AAlsaati/SmartWatch/Hardware/Basic/Bottom/SmartWatch-BASIC-Bottom-BOM.xlsx

Design Name -- Revision Code / Designer or Organization Name |  |  |  |  |  |  |  |  |  |  | Total | $21.12 | Total (in Bulk) | $0.00
BOM # | Comment | Designator | Description | Mounting Type | Package | Manufacturer | Manufacturer Part Number | Supplier | Supplier Part Number | Price per unit | Quantity | Total | Per 100 | Total
Filters
 | Op Amp - MCP6004 | OP3 | General Purpose Amplifier 4 Circuit Rail-to-Rail 14-SOIC | SMD | 14-SOIC | Microchip Technology | MCP6004T-I/SL | Digi-Key | MCP6004T-I/SLCT-ND | $0.44 | 6 | $2.64
 | 100 nF Capacitor | C10 | 0.1µF ±5% 16V Ceramic Capacitor X7R 0603 (1608 Metric) | SMD | 0603 | Yageo | CC0603JRX7R7BB104 | Digi-Key | 311-1776-1-ND | $0.03 | 1 | $0.03
 | 2.2u capacitor | C15, C16 | 2.2µF ±10% 16V Ceramic Capacitor X5R 0603 (1608 Metric) | SMD | 0603 | Samsung Electro-Mechanics | CL10A225KO8NNNC | Digi-Key | 1276-1040-1-ND | $0.03 | 2 | $0.06
 | 2.2n Capacitor | C14, C19 | 2200pF ±10% 50V Ceramic Capacitor X7R 0603 (1608 Metric) | SMD | 0603 | Walsin Technology Corporation | 0603B222K500CT | Digi-Key | 1292-1412-1-ND | $0.01 | 2 | $0.02
 | 22u capacitor | C20 | 22µF ±20% 10V Ceramic Capacitor X5R 0603 (1608 Metric) | SMD | 0603 | Samsung Electro-Mechanics | CL10A226MP8NUNE | Digi-Key | 1276-1274-1-ND | $0.07 | 1 | $0.07
 | 22n capacitor | C21 | 0.022µF ±10% 50V Ceramic Capacitor X7R 0603 (1608 Metric) | SMD | 0603 | Samsung Electro-Mechanics | CL10B223KB8NNNC | Digi-Key | 1276-1104-1-ND | $0.02 | 1 | $0.02
 | 220k resistor | R13, R19, R21, R15 | 220 kOhms ±1% 0.1W, 1/10W Chip Resistor 0603 (1608 Metric) Automotive AEC-Q200 Thick Film | SMD | 0603 | Stackpole Electronics Inc | RMCF0603FT220K | Digi-Key | RMCF0603FT220KCT-ND | $0.01 | 4 | $0.02
 | 10M Resistor | R14,R22 | 10 MOhms ±1% 0.1W, 1/10W Chip Resistor 0603 (1608 Metric) Automotive AEC-Q200 Thick Film | SMD | 0603 | Stackpole Electronics Inc | RMCF0603FT10M0 | Digi-Key | RMCF0603FT10M0CT-ND | $0.01 | 2 | $0.02
 | 1M Resistor | R20, R23 | 1 MOhms ±1% 0.1W, 1/10W Chip Resistor 0603 (1608 Metric) Automotive AEC-Q200 Thick Film | SMD | 0603 | Stackpole Electronics Inc | RMCF0603FT1M00 | Digi-Key | RMCF0603FT1M00CT-ND | $0.01 | 2 | $0.01
 | 10k Resistor | R24 | 10 kOhms ±1% 0.1W, 1/10W Chip Resistor 0603 (1608 Metric) Automotive AEC-Q200 Thick Film | SMD | 0603 | Stackpole Electronics Inc | RMCF0603FT10K0 | Digi-Key | RMCF0603FT10K0CT-ND | $0.01 | 1 | $0.01
 | 100 nF Capacitor | C22,C11,C1 | 0.1µF ±5% 16V Ceramic Capacitor X7R 0603 (1608 Metric) | SMD | 0603 | Yageo | CC0603JRX7R7BB104 | Digi-Key | 311-1776-1-ND | $0.03 | 100 | $3.31
 | 10k Resistor | R17, R18 | 10 kOhms ±1% 0.1W, 1/10W Chip Resistor 0603 (1608 Metric) Automotive AEC-Q200 Thick Film | SMD | 0603 | Stackpole Electronics Inc | RMCF0603FT10K0 | Digi-Key | RMCF0603FT10K0CT-ND | $0.01 | 100 | $0.59
Pontentiometer
 | AD5242 | AD5242 | Digital Potentiometer 1M Ohm 2 Circuit 256 Taps I²C Interface 16-SOIC | SMD | 16-SOIC | Analog Devices Inc. | AD5242BRZ1M | Digi-Key | AD5242BRZ1M-ND | $3.47 | 1 | $3.47
 | AD5171 | AD5171 | Digital Potentiometer ICs IC 6-Bit OTP I2C | SMD | SOT-23-8 | Analog Devices | AD5171BRJZ100-R7 | Mouser | 584-AD5171BRJZ100-R7 | $2.68 | 1 | $2.68
 | 100 nF Capacitor | C17, C18 | 0.1µF ±5% 16V Ceramic Capacitor X7R 0603 (1608 Metric) | SMD | 0603 | Yageo | CC0603JRX7R7BB104 | Digi-Key | 311-1776-1-ND | $0.03 | 2 | $0.07
 |  | R16
 | NPN-Generic | Q1 | Bipolar (BJT) Transistor NPN 40V 600mA 300MHz 250mW Surface Mount TO-236AB | SMD | TO-236AB | Nexperia USA Inc. | PMBT2222A,215 | Digi-Key | 1727-2956-1-ND | $1.05 | 1 | $1.05
IMU
 | LSM6DS3 castellated breakout
 | 100 nF Capacitor | C25 | 0.1µF ±5% 16V Ceramic Capacitor X7R 0603 (1608 Metric) | SMD | 0603 | Yageo | CC0603JRX7R7BB104 | Digi-Key | 311-1776-1-ND | $0.03 | 1 | $0.03
 | CONN_07-1.27MM (CONN_07) |  | 50 Position Header Connector 0.050" (1.27mm) Through Hole Gold | THT |  | Sullins Connector Solutions | LPPB501NFFN-RC | Digi-Key | S9008E-50-ND | $5.06 | 1 | $5.06
RTC
 | PCF8523 | U3 | Real Time Clock (RTC) IC Clock/Calendar I²C, 2-Wire Serial 8-SOIC (0.154", 3.90mm Width) | SMD | 8-SO | NXP USA Inc. | PCF8523T/1,118 | Digi-Key | 568-5306-1-ND | $1.26 | 1 | $1.26
 | 1uF capacitor | C2 | 1µF ±10% 25V Ceramic Capacitor X5R 0603 (1608 Metric) | SMD | 0603 | Samsung Electro-Mechanics | CL10A105KA8NNNC | Digi-Key | 1276-1102-1-ND | $0.10 | 1 | $0.10
 | CRYSTALECS-.327-12.5-12-C-TR (CRYSTAL) (32.7680kHz) | XTAL2 | 32.768kHz ±10ppm Crystal 12.5pF 90 kOhms 2-SMD, No Lead | SMD | 2-SMD, No Lead | ECS Inc. | ECS-.327-12.5-12-C-TR | Digi-Key | XC2288CT-ND | $0.60 | 1 | $0.60
