AAlsaati/SmartWatch/Hardware/Basic/TOP/SmartWatch-BASIC-TOP-BOM.xlsx

Design Name -- Revision Code / Designer or Organization Name |  |  |  |  |  |  |  |  |  |  | Total | $24.10 | Total (in Bulk) | $0.00
BOM # | Comment | Designator | Description | Mounting Type | Package | Manufacturer | Manufacturer Part Number | Supplier | Supplier Part Number | Price per unit | Quantity | Total | Per 100 | Total
Microcontroller
1 | NRF52832_MODULE_MDBT42 | U1 | Bluetooth Bluetooth v4.2 Transceiver Module 2.4GHz Integrated, Chip Surface Mount | SMD | 41-SMD Module | Seeed Technology Co., Ltd | 317030213 | Digi-Key | 1597-1434-ND | $10.10 | 1 | $10.10
2 | 10k Resistor | R1, R2, | 10 kOhms ±1% 0.1W, 1/10W Chip Resistor 0603 (1608 Metric) Automotive AEC-Q200 Thick Film | SMD | 0603 | Stackpole Electronics Inc | RMCF0603FT10K0 | Digi-Key | RMCF0603FT10K0CT-ND | $0.01 | 2 | $0.01
3 | 1k Resistor | R4,R6 | 1 kOhms ±1% 0.1W, 1/10W Chip Resistor 0603 (1608 Metric) Automotive AEC-Q200 Thick Film | SMD | 0603 | Stackpole Electronics Inc | RMCF0603FT1K00 | Digi-Key | RMCF0603FT1K00CT-ND | $0.01 | 2 | $0.01
4 | Tiny Rectangular Switch | SW4 | Tactile Switch SPST-NO Top Actuated Surface Mount | SMD | Gull Wing | C&K Components | PTS830GM140 SMTR LFS | Digi-Key | CKN10587CT-ND | $0.57 | 1 | $0.57
5 | 10µH Inductor | L1 | 10µH Shielded Multilayer Inductor 250mA 1.05Ohm 0603 (1608 Metric) | SMD | 0603 | TDK Corporation | MLZ1608M100WTD25 | Digi-Key | MLZ1608M100WTD25 | $0.22 | 1 | $0.22
6 | 1uF capacitor | C1 | 1µF ±10% 25V Ceramic Capacitor X5R 0603 (1608 Metric) | SMD | 0603 | Samsung Electro-Mechanics | CL10A105KA8NNNC | Digi-Key | 1276-1102-1-ND | $0.10 | 1 | $0.10
7 | 10 uF 0603 Capacitor | C2 | 10µF ±10% 10V Ceramic Capacitor X5R 0603 (1608 Metric) | SMD | 0603 | Murata Electronics | GRM188R61A106KE69J | Digi-Key | 490-14372-1-ND | $0.06 | 1 | $0.06
8 | 12pF capacitor | C3, C4 | 12pF ±5% 50V Ceramic Capacitor C0G, NP0 0603 (1608 Metric) | SMD | 0603 | Walsin Technology Corporation | 0603N120J500CT | Digi-Key | 1292-1480-1-ND | $0.01 | 2 | $0.02
9 | Red LED | LED1 | Red 622nm LED Indication - Discrete 2.2V 0603 (1608 Metric) | SMD | 0603 | Inolux | IN-S63ATR | Digi-Key | 1830-1065-1-ND | $0.18 | 1 | $0.18
10 | Blue LED | LED2 | Blue 470nm LED Indication - Discrete 3V 0603 (1608 Metric) | SMD | 0603 | Inolux | IN-S63AT5B | Digi-Key | 1830-1061-1-ND | $0.18 | 1 | $0.18
11 | CRYSTALECS-.327-12.5-12-C-TR (CRYSTAL) (32.7680kHz) | XTAL1 | 32.768kHz ±10ppm Crystal 12.5pF 90 kOhms 2-SMD, No Lead | SMD | 2-SMD, No Lead | ECS Inc. | ECS-.327-12.5-12-C-TR | Digi-Key | XC2288CT-ND | $0.60 | 1 | $0.60
FTDI - USB |  |  |  |  |  |  |  |  |  |  |  | $0.00
12 | FT231XS USB Serial | U3 | USB Bridge, USB to UART USB 2.0 UART Interface 20-SSOP | SMD | 20-SSOP | FTDI, Future Technology Devices International Ltd | FT231XS-U | Digi-Key | 768-1156-5-ND | $2.12 | 1 | $2.12
13 | 47 pF Capacitor | C15, C16 | 47pF ±5% 50V Ceramic Capacitor C0G, NP0 0603 (1608 Metric) | SMD | 0603 | Walsin Technology Corporation | 0603N470J500CT | Digi-Key | 1292-1528-1-ND | $0.01 | 2 | $0.02
14 | 27 ohm resistor | R11, R12 | 27 Ohms ±1% 0.1W, 1/10W Chip Resistor 0603 (1608 Metric) Automotive AEC-Q200 Thick Film | SMD | 0603 | Stackpole Electronics Inc | RMCF0603FT27R0 | Digi-Key | RMCF0603FT27R0CT-ND | $0.01 | 2 | $0.01
15 | 100 nF Capacitor | C17 | 0.1µF ±5% 16V Ceramic Capacitor X7R 0603 (1608 Metric) | SMD | 0603 | Yageo | CC0603JRX7R7BB104 | Digi-Key | 311-1776-1-ND | $0.03 | 1 | $0.03
16 | 0 ohm resistor (not sure if needed) | JP1, R15, R16 | 0 Ohms Jumper 0.1W, 1/10W Chip Resistor 0603 (1608 Metric) Moisture Resistant Thick Film | SMD | 0603 | Yageo | RC0603JR-070RL | Digi-Key | 311-0.0GRCT-ND | $0.01 | 3 | $0.02
17 | 1k Resistor | R13,R14 | 1 kOhms ±1% 0.1W, 1/10W Chip Resistor 0603 (1608 Metric) Automotive AEC-Q200 Thick Film | SMD | 0603 | Stackpole Electronics Inc | RMCF0603FT1K00 | Digi-Key | RMCF0603FT1K00CT-ND | $0.01 | 2 | $0.01
18 | Red LED | LED3 | Red 622nm LED Indication - Discrete 2.2V 0603 (1608 Metric) | SMD | 0603 | Inolux | IN-S63ATR | Digi-Key | 1830-1065-1-ND | $0.18 | 1 | $0.18
19 | Yellow LED | LED4 | Yellow 590nm LED Indication - Discrete 2V 0603 (1608 Metric) | SMD | 0603 | Wurth Electronics Inc. | 150060YS75000 | Digi-Key | 732-4981-1-ND | $0.14 | 1 | $0.14
Debug |  |  |  |  |  |  |  |  |  |  |  | $0.00
20 | Cortex Debug Connector - 10 pin | DEBUG1 | Connector Header Through Hole 10 position 0.050" (1.27mm) | THT | NA | Amphenol ICC (FCI) | 20021111-00010T4LF | Digi-Key | 609-3712-ND | $0.69 | 1 | $0.69
RTC |  |  |  |  |  |  |  |  |  |  |  | $0.00
21 | 100 nF Capacitor | C18 | 0.1µF ±5% 16V Ceramic Capacitor X7R 0603 (1608 Metric) | SMD | 0603 | Yageo | CC0603JRX7R7BB104 | Digi-Key | 311-1776-1-ND | $0.03 | 1 | $0.03
22 | 10k Resistor | R17 | 10 kOhms ±1% 0.1W, 1/10W Chip Resistor 0603 (1608 Metric) Automotive AEC-Q200 Thick Film | SMD | 0603 | Stackpole Electronics Inc | RMCF0603FT10K0 | Digi-Key | RMCF0603FT10K0CT-ND | $0.01 | 1 | $0.01
23 | Schottky Diode | D3 | Diode Schottky 30V 1.5A Surface Mount USC | SMD | USC | Toshiba Semiconductor and Storage | CUS15S30,H3F | Digi-Key | CUS15S30H3FCT-ND | $0.26 | 1 | $0.26
24 | Tiny Rectangular Switch | SW4 | Tactile Switch SPST-NO Top Actuated Surface Mount | SMD | Gull Wing | C&K Components | PTS830GM140 SMTR LFS | Digi-Key | CKN10587CT-ND | $0.57 | 1 | $0.57
OLED |  |  |  |  |  |  |  |  |  |  |  | $0.00
25 | 0.96" OLED | OLED | Datasheet 128x64 OLED Module SPI 0.96"Graphic Displays,White on Black | SMD | Flexible Connector | EastRising | https://www.buydisplay.com/datasheet-128x64-oled-module-spi-0-96-inch-graphic-displays-white-on-black | BuyDisplay.com | https://www.buydisplay.com/datasheet-128x64-oled-module-spi-0-96-inch-graphic-displays-white-on-black | $2.51 | 1 | $2.51
26 | 10 uF 0603 Capacitor | C9 | 10µF ±10% 10V Ceramic Capacitor X5R 0603 (1608 Metric) | SMD | 0603 | Murata Electronics | GRM188R61A106KE69J | Digi-Key | 490-14372-1-ND | $0.06 |  | $0.00
27 | 2.2u capacitor | C10, C11, C12, C13, C14 | 2.2µF ±10% 16V Ceramic Capacitor X5R 0603 (1608 Metric) | SMD | 0603 | Samsung Electro-Mechanics | CL10A225KO8NNNC | Digi-Key | 1276-1040-1-ND | $0.03 | 5 | $0.16
28 | 10k Resistor | R9 | 10 kOhms ±1% 0.1W, 1/10W Chip Resistor 0603 (1608 Metric) Automotive AEC-Q200 Thick Film | SMD | 0603 | Stackpole Electronics Inc | RMCF0603FT10K0 | Digi-Key | RMCF0603FT10K0CT-ND | $0.01 | 1 | $0.01
29 | 390k resistor | R10 | 390 kOhms ±1% 0.1W, 1/10W Chip Resistor 0603 (1608 Metric) Automotive AEC-Q200 Thick Film | SMD | 0603 | Stackpole Electronics Inc | RMCF0603FG390K | Digi-Key | RMCF0603FG390KCT-ND | $0.01 | 1 | $0.01
Bottons |  |  |  |  |  |  |  |  |  |  |  | $0.00
30 | SWITCH.MOM (TACTILE_SWITCH_SMD_6.2MM_TALL) | SW2, SW3 | Tactile Switch SPST-NO Top Actuated Surface Mount - TACT 4.5 X 4.5, 5.0 MM H, 1.0N, | SMD | Gull Wing | C&K | PTS 647 SN50 SMTR2 LFS | Digi-Key | PTS647SN50SMTR2LFSCT-ND | $0.12 | 2 | $0.24
Connectors |  |  |  |  |  |  |  |  |  |  |  | $0.00
31 | CONN_07-1.27MM | J2 | 50 Positions Header Connector 0.050" (1.27mm) Through Hole Gold | THT |  | Sullins Connector Solutions | GRPB501VWVN-RC | Digi-Key | S9014E-50-ND | $3.11 | 1 | $3.11
Power |  |  |  |  |  |  |  |  |  |  |  | $0.00
32 | Micro USB | USB1 | USB - micro B USB 2.0 Receptacle Connector 5 Position Surface Mount, Right Angle | SMD | Flange, Horizontal | Amphenol FCI | 10118192-0001LF | Digi-Key | 609-4613-1-ND | $0.43 | 1 | $0.43
33 | Schottky Diode | D1, D2 | Diode Schottky 30V 1.5A Surface Mount USC | SMD | USC | Toshiba Semiconductor and Storage | CUS15S30,H3F | Digi-Key | CUS15S30H3FCT-ND | $0.26 | 2 | $0.51
34 | 4.7 uF Capacitor | C5, C8 | red 622nm LED Indication - Discrete 2.2V 0603 (1608 Metric) | SMD | 0603 | Samsung Electro-Mechanics | CL10A475KO8NNNC | Digi-Key | 1276-1784-1-ND | $0.04 | 2 | $0.09
35 | 1uF capacitor | C6, C7 | 1µF ±10% 25V Ceramic Capacitor X5R 0603 (1608 Metric) | SMD | 0603 | Samsung Electro-Mechanics | CL10A105KA8NNNC | Digi-Key | 1276-1102-1-ND | $0.10 | 2 | $0.20
36 | 100k Resistor | R3, R7, R8 | 100 kOhms ±1% 0.1W, 1/10W Chip Resistor 0603 (1608 Metric) Automotive AEC-Q200 Thick Film | SMD | 0603 | Stackpole Electronics Inc | RMCF0603FT100K | Digi-Key | RMCF0603FT100KCT-ND | $0.01 | 3 | $0.02
37 | 4.7k resistor | R5 | 4.7 kOhms ±1% 0.1W, 1/10W Chip Resistor 0603 (1608 Metric) Automotive AEC-Q200 Thick Film | SMD | 0603 | Stackpole Electronics Inc | RMCF0603FT4K70 | Digi-Key | RMCF0603FT4K70CT-ND | $0.01 | 1 | $0.01
38 | MIC5504-3.3V | LDO1 | Linear Voltage Regulator IC 1 Output 300mA SOT-23-5 | SMD | SOT23-5 | Microchip Technology | MIC5504-3.3YM5-TR | Digi-Key | 576-4764-1-ND | $0.11 | 1 | $0.11
39 | MCP73831 T Li-Ion, Li-Pol Controller | CHRG1 | Charger IC Lithium-Ion/Polymer SOT-23-5 | SMD | SOT-23-5 | Microchip Technology | MCP73831T-2ACI/OT | Digi-Key | MCP73831T-2ACI/OTCT-ND | $0.56 | 1 | $0.56
