AAlsaati/SmartWatch/(commit log)

2021-02-27 Bottom Board
    [SmartWatch-BASIC-Bottom.brd, SmartWatch-BASIC-Bottom.sch]
2021-02-28 take 2
    [SmartWatch-BASIC-Bottom.brd, SmartWatch-BASIC-Bottom.sch, SmartWatch-BASIC-TOP.brd, SmartWatch-BASIC-TOP.sch]
2021-03-14 take 8
    [SmartWatch-BASIC-TOP.brd, SmartWatch-BASIC-TOP.sch]
